fhirschmann/halo2-controller/case/scan/devkit-v1-2026-10-27.jpg

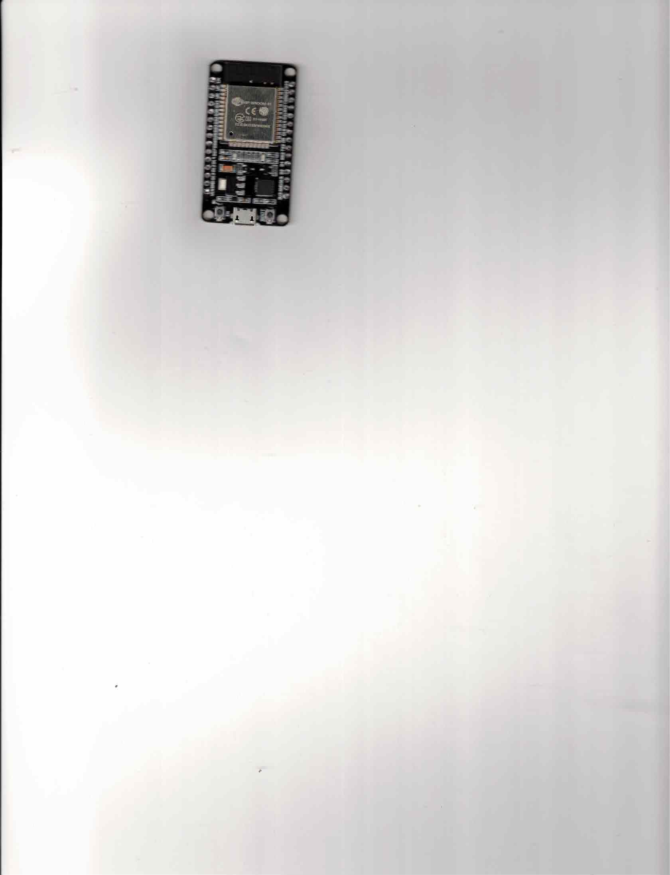
case/scan/devkit-v1-2026-10-27.jpg
