fhirschmann/halo2-controller/case/scan/devkit-bm5602-2026-10-27.jpg

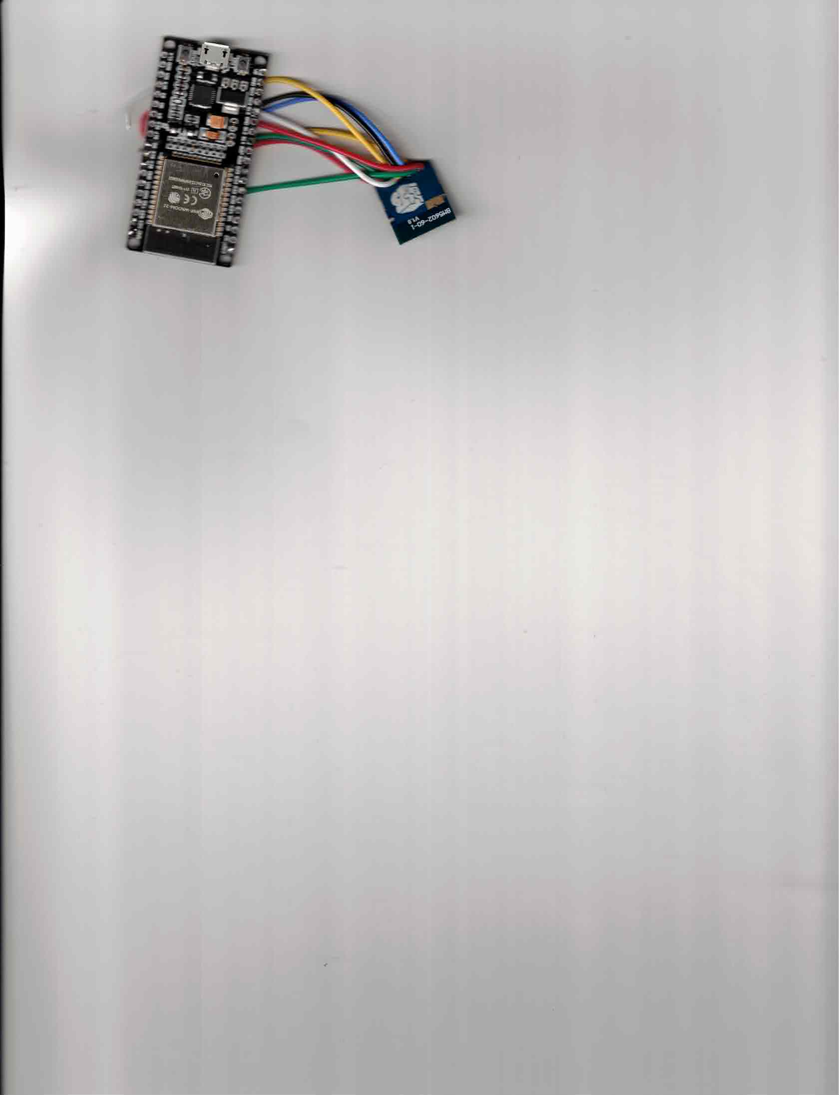
case/scan/devkit-bm5602-2026-10-27.jpg
