fhirschmann/halo2-controller/case/scan/usbc-pd-board-2026-10-27.jpg

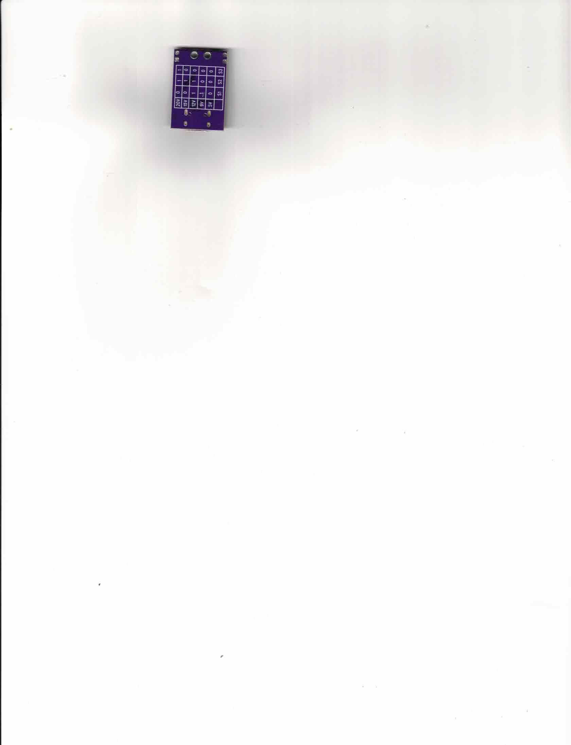
case/scan/usbc-pd-board-2026-10-27.jpg
