fhirschmann/halo2-controller/case/stl/lid.stl

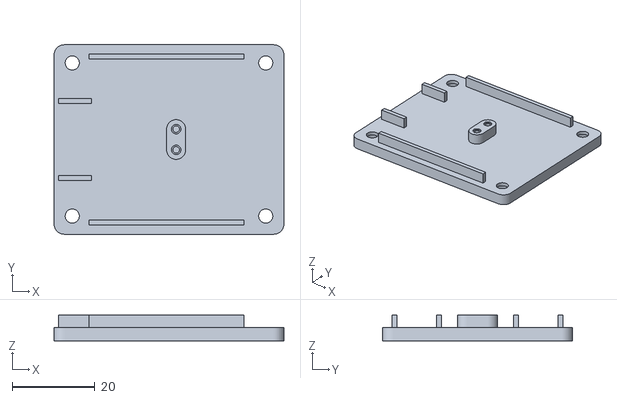
[picture p4: CAD file, 2026-10-28]
case/stl/lid.stl
55.4 x 45.7 x 6.20
