fhirschmann/halo2-controller/case/stl/multicolour/box_qr.stl

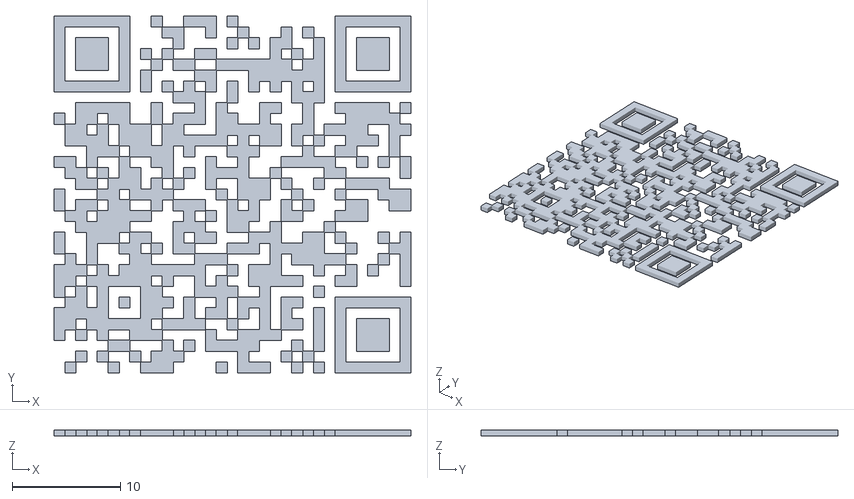
[picture p5: CAD file, 2026-10-28]
case/stl/multicolour/box_qr.stl
33.0 x 33.0 x 0.6
