fhirschmann/halo2-controller/case/stl/halo2_case.3mf

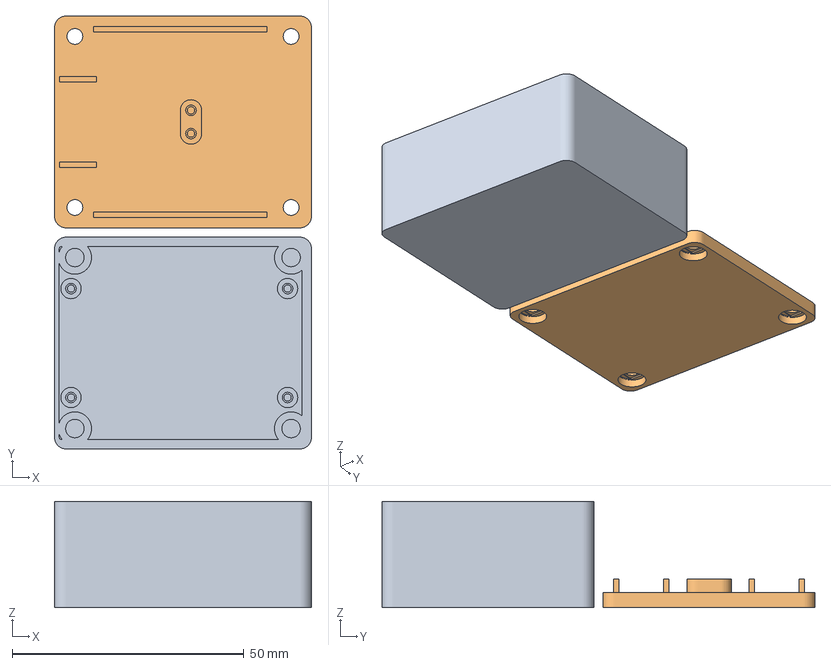
[picture p6: CAD file, 2026-10-28]
case/stl/halo2_case.3mf
55.4 x 93.4 x 22.9 mm
lid_1
