fhirschmann/halo2-controller/case/stl/multicolour/box_base.stl

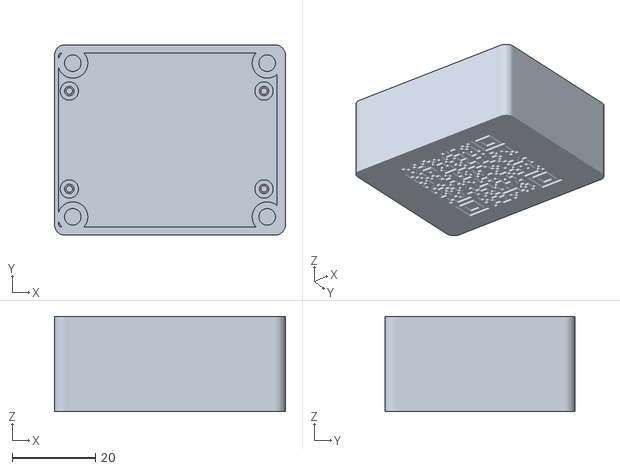
[picture p7: CAD file, 2026-10-28]
case/stl/multicolour/box_base.stl
55.4 x 45.7 x 22.9
