fhirschmann/halo2-controller/(list of files, cad)

Other CAD files:
case/stl/box.stl
