fhirschmann/halo2-controller/(commit log)

2026-10-27 Base: halo2 component from NickCao/benq-screenbar-halo2-esphome
    Taken over unchanged from commit dd110a8d4599c9a73ec36f87c2cf45c5e016ad42
    (MIT licence, see LICENSE). The next step replaces the LR1121 radio layer
    with a BM5602 driver.
2026-10-27 Firmware: BM5602 radio layer instead of LR1121, own ESPHome configuration
    - bm5602_radio.h: the BC5602's packet engine (auto-ACK with payload) as in
    kuzmin-no; clear flags and FIFOs only in sleep mode, chip reset after MAX_RT.
    Passive listening to the remote between queries.
    - halo2.cpp: discovery and LR1121 parts removed, unacknowledged commands are
    resent up to three times with the full state, status queries made distinguishable.
    - Self-test (self_test: true) checks every setting against fresh lamp
    replies; passed 24/24 on the author's lamp.
    - screenbar-halo2.yaml for an ESP32 DevKit (VSPI 18/23/19, CS 5), German entity names.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
2026-10-27 Firmware: SDIO on GPIO22, note on a mislabelled GND pin
    Not every ESP32 board breaks out GPIO23. The first DevKit was damaged on
    2026-10-27 through a CMD pin labelled GND.
2026-10-28 Firmware: register the SPI device only once, status with the DOIT board
    A second init attempt after a failed chip probe registered the SPI device again
    ("Device already registered"). Now only the first time; retries only reinitialise the chip.
    README: runs on a DOIT ESP32 DevKit V1, pin positions on that board, OTA by IP.
2026-10-28 README: the PD board was set to 9 V when the damage happened; connect it to VIN at 5 V
2026-10-28 Case: DOIT DevKit V1, PD board with M2 in the lid, QR code on the bottom
    opp project in case/: box with lid for the DOIT ESP32 DevKit V1 with the BM5602 underneath and
    the USB-C PD board under the lid. Both boards held by M2 x 6 self-tapping screws, lid with four
    ISO 7380 M3 x 8 into Ruthex inserts, micro-USB and USB-C one above the other in the front wall.
    Inverted QR code to the future GitHub repo in the first three bottom layers (AMS, two colours).
    26 g, 1.2 h.
    [box.stl, box_base.stl, box_qr.stl, halo2_case.3mf, halo2_case.scad, lid.stl, qr_repo.scad]
2026-10-28 Translate entity names, comments and documentation to English
    Entity names and select options in HA are now English, so are the README, the case README,
    the ESPHome comments and secrets.example.yaml. Network details stay out of the public README.
2026-10-28 README: drop the story of the damaged first board, keep the GND warning
2026-10-28 README: rewrite as a build guide instead of a project log
    Parts list, wiring, finding the lamp address with kuzmin-no's script under MicroPython,
    build and flash, adding it to Home Assistant. The case README now has a parts list, print
    notes, assembly steps and the parameters to adapt for other boards.
2026-10-28 Firmware: ignore stale status replies for 3 s after a state change
    After a command the lamp still reported its old power state 1.2 s later, so the light entity
    flipped back for a few seconds and automations following it toggled twice. Status polls now
    start 3 s after a command or an overheard remote frame, and replies inside that window are
    not applied.
2026-10-28 Firmware: do not apply the remote's stale status queries
    After a button press the remote keeps polling the lamp with command 04, whose payload is the
    state the remote believes in; for the first one or two seconds that is still the old one, so the
    light flipped back. Such queries now only count outside the settle window and when they differ.
2026-10-28 Case: printed, fits both boards; project finished
2026-10-28 Firmware: take on/off from the remote only from POWER commands
    Woken from sleep, the remote first sends command 00 frames with power 0 while the lamp stays
    on; the light entity went off and came back three seconds later. Wake-up frames are now ignored,
    and the power bit of other remote commands is not applied.
